merterenkandilli/EE463-Term-Project-Group-1/README.md

# EE463-Term-Project-Group-1
EMK
This is repo for EE463 term project of group1
