merterenkandilli/EE463-Term-Project-Group-1/Thermal Calculations.docx

Thermal Calculations

In this part of the report, the thermal analysis of the design is displayed. The main losses in the design are caused by the semiconductor devices. The most significant losses occur in a semiconductor while it is in conduction mode or it is switching. One can find the approximate total loss by adding the conduction loss and switching loss as shown in Equation 4.1.

P_(loss) = P_(conduction) + P_(switching)

Equation 4.1

The conduction losses can be calculated by two methods as shown in Equation 4.2 and Equation 4.3. In the first method, one can use the forward voltage drop of the semiconductor ( V_f ) to calculate the power dissipation. Another possible method is to use the on-resistance value ( R_(ds) ) indicated in the datasheet.

P_(conduction) = V_f ×I_(on) ×(Duty Cycle)

Equation 4.2

P_(conduction) = R_(ds) ×I_(on)^2 ×(Duty Cycle)

Equation 4.3

Switching losses can be calculated as shown in Equation 4.4 by using the turn on energy ( E_(on) ) and turn off energy ( E_(off) ) dissipated while the diode is switching . If these parameters are not indicated in the datasheet, the switching loss can be estimated by using the turn on delay time ( t_(rise) ) and turn of delay time ( t_(fall) ) as displayed in Equation 4.5.

P_(switching) =(E_(on) + E_(off) )×f

Equation 4.4

P_(switching) ≃ I_(on) × V_(on) ×(t_(rise) +t_(fall) )×f

Equation 4.5

For the rectifier block, two single phase bridge rectifiers (KBPC3510) are combined to construct a three phase full bridge rectifier. The switching energy or delay times are not indicated in the datasheet of the component. The maximum V_f is indicated as 1.1V in the datasheet. In maximum load case, the average current passing on one diode is 11 A when the diode is in conduction mode. One diode’s duty cycle is 1/6. There are 4 diodes that is working in one rectifier while only 2 diodes are working in the other.

P_(loss-rectifier1) =(1.1V)×(11A)×(1/6)×4=8.07W

P_(loss-rectifier2) =(1.1V)×(11A)×(1/6)×2=4.03W

The diode used in buck converter is DHG30I600PA.The diode’s conduction loss depends on both on-current and duty cycle. The maximum current is 11 A but the conduction loss is low because the duty cycle is 0.1 at that current. Thus, the maximum conduction loss occurs when duty cycle is 0.5 and the current is approximately 6A. Since the switching energy dissipation is not indicated in the datasheet, the Equation 4.5 is used to calculate switching loss. The switching loss is maximum when the duty cycle of the switch is maximum (0.9) since the current is maximum (0.44W). However, the conduction loss is more dominant than switching loss for this application in general. Thus, the worst case is calculated for 0.5 duty cycle.

P_(loss-diode,conduction) = 2.27V × 6A × 0.5 = 6.81W

P_(loss-diode,switching) ≃ 6A × 202V×(40 ns)×(5 kHz)=0.24W

P_(loss-diode) ≃7.05W

In IGBT, the maximum switching loss and conduction loss occur when duty cycle is 0.9. The calculations are displayed below.

P_(loss-IGBT,conduction) = (1.5V) × (11.2 A) × 0.8 =13.44W

P_(loss-IGBT,switching) =(0.3mJ+0.4mJ)× (5kHz)=3.5W

P_(loss-IGBT) =16.94W

To find the maximum thermal resistance of the heatsink, the following two equations are used.

R_(th-needed) = R_(jc) +R_(th-heatsink)

Equation 7

R_(th-needed) =(T_(max) -T_(ambient) )÷(P)

Equation 8

For rectifiers;

R_(th-needed,rectifier1) =(150-25)C^o ÷(8.07)=15.45 C/W

R_(th-heatsink,rectifier1) = 15.45 C/W -2 C/W = 13.45 C/W

R_(th-needed,rectifier2) =(150-25)C^o ÷(8.07)=31.02 C/W

R_(th-heatsink,rectifier2) = 15.45 C/W -2 C/W = 29.02 C/W

For diode (buck converter);

R_(th-needed,diode) =(125 C^o )÷(7.05)=17.73 C/W

R_(th-heatsink,diode) = 17.73 C/W -0.7 C/W = 17.03 C/W

For IGBT;

R_(th-needed,IGBT) =(125 C^o )÷(16.94)=7.38 C/W

R_(th-heatsink,IGBT) = 7.38 C/W -0.8 C/W = 6.58 C/W

In the implementation phase, we used a huge heatsink (thermal resistance is unknown but it is very low) and connected all of these semiconductor devices to this heatsink. Moreover, we used a fan to improve our thermal parameters.
