merterenkandilli/EE463-Term-Project-Group-1/controller/current_sense.PNG

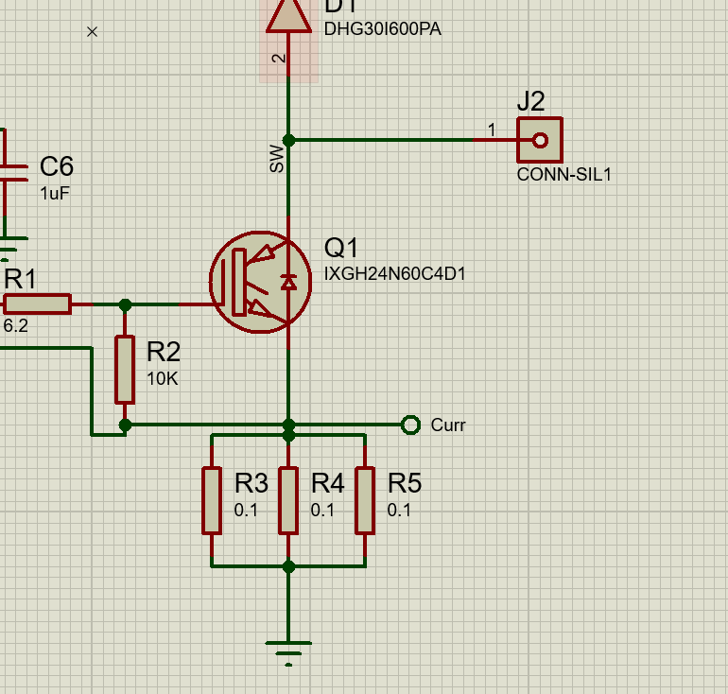
controller/current_sense.PNG
