merterenkandilli/EE463-Term-Project-Group-1/controller/kelvin.PNG

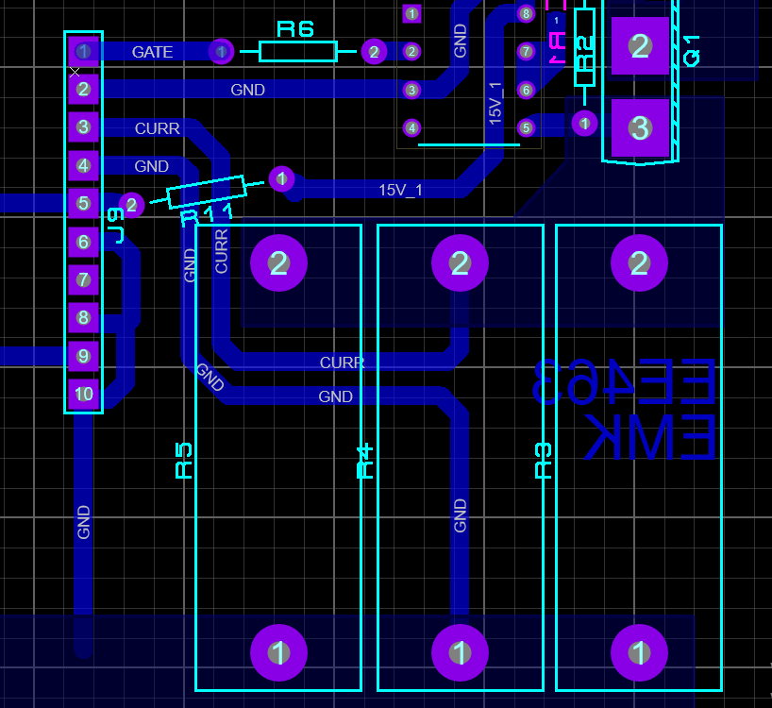
controller/kelvin.PNG
