merterenkandilli/EE463-Term-Project-Group-1/controller/pinout.PNG

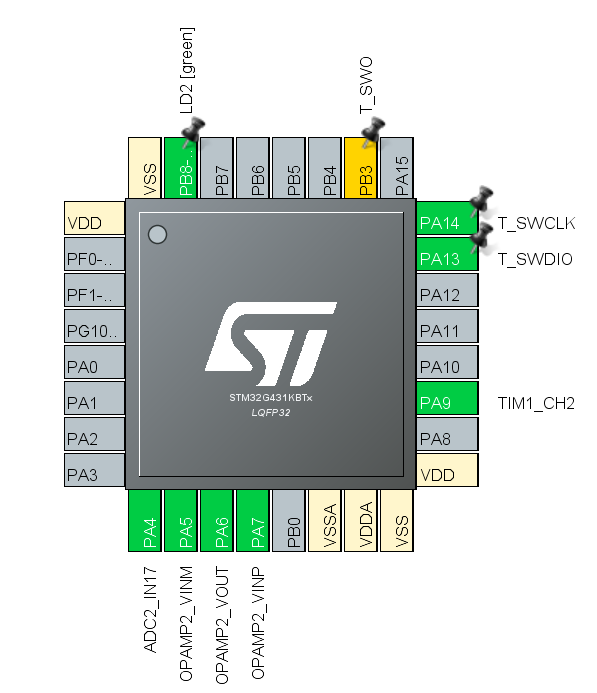
controller/pinout.PNG
