merterenkandilli/EE463-Term-Project-Group-1/controller/start.PNG

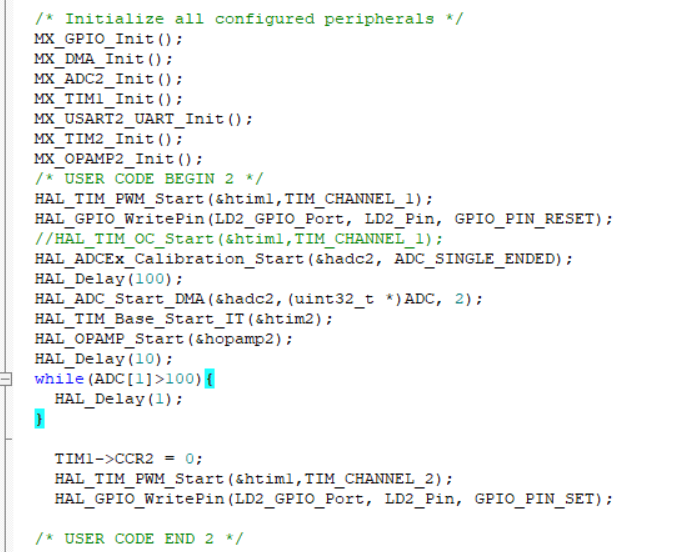
controller/start.PNG
