merterenkandilli/EE463-Term-Project-Group-1/figures/armature_current_ar_ss.png

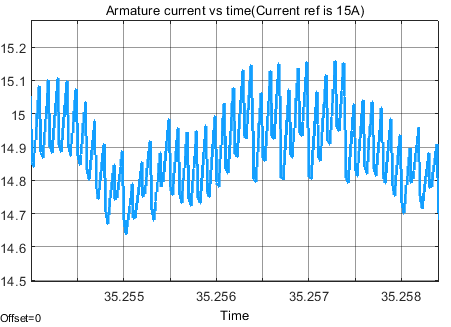
figures/armature_current_ar_ss.png
