merterenkandilli/EE463-Term-Project-Group-1/figures/armature_current_at_startup.png

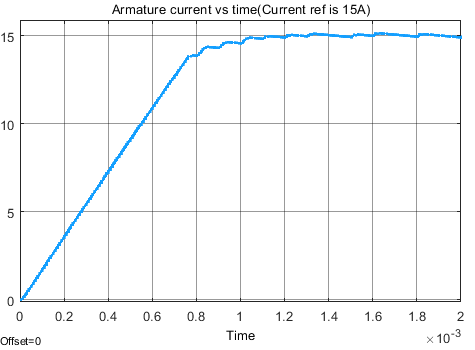
figures/armature_current_at_startup.png
