merterenkandilli/EE463-Term-Project-Group-1/figures/freewheeling_current_long.png

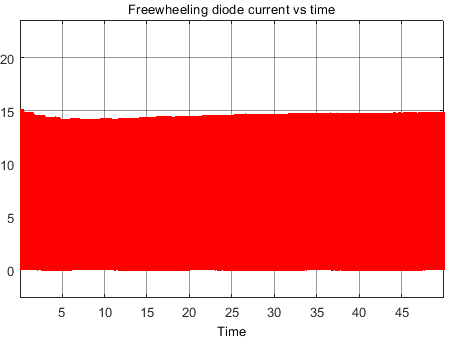
figures/freewheeling_current_long.png
