merterenkandilli/EE463-Term-Project-Group-1/figures/freewheeling_voltage_short2.png

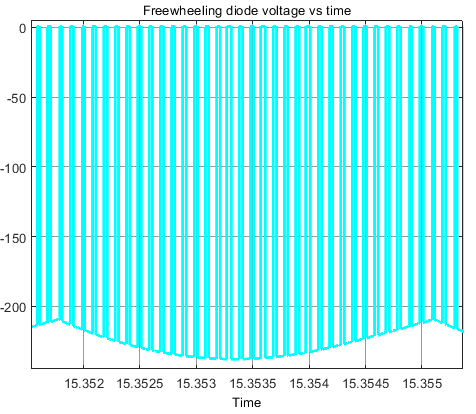
figures/freewheeling_voltage_short2.png
