merterenkandilli/EE463-Term-Project-Group-1/figures/igbt_current_long.png

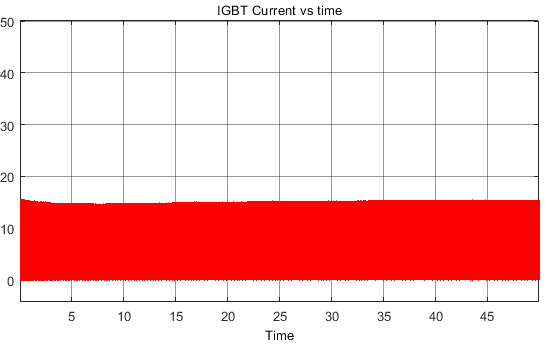
figures/igbt_current_long.png
