merterenkandilli/EE463-Term-Project-Group-1/figures/igbt_current_short2.png

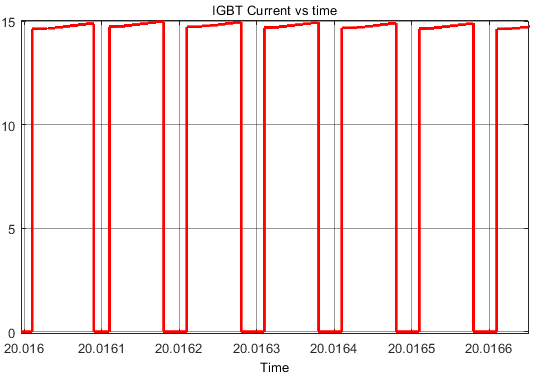
figures/igbt_current_short2.png
