merterenkandilli/EE463-Term-Project-Group-1/figures/igbt_currentvoltage_2.png

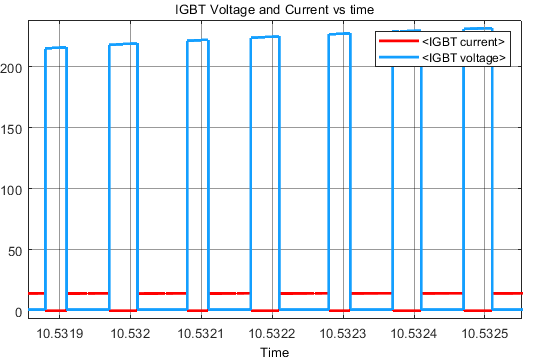
figures/igbt_currentvoltage_2.png
