merterenkandilli/EE463-Term-Project-Group-1/figures/igbt_voltage_short1.png

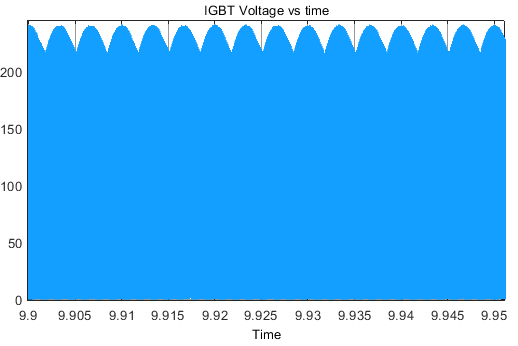
figures/igbt_voltage_short1.png
