merterenkandilli/EE463-Term-Project-Group-1/figures/igbt_voltage_short2.png

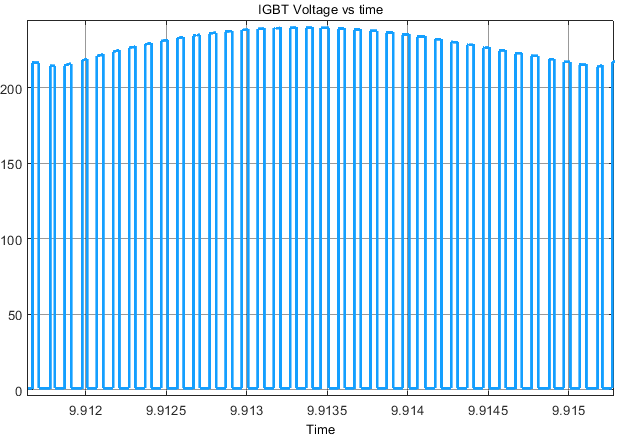
figures/igbt_voltage_short2.png
