merterenkandilli/EE463-Term-Project-Group-1/figures/model.PNG

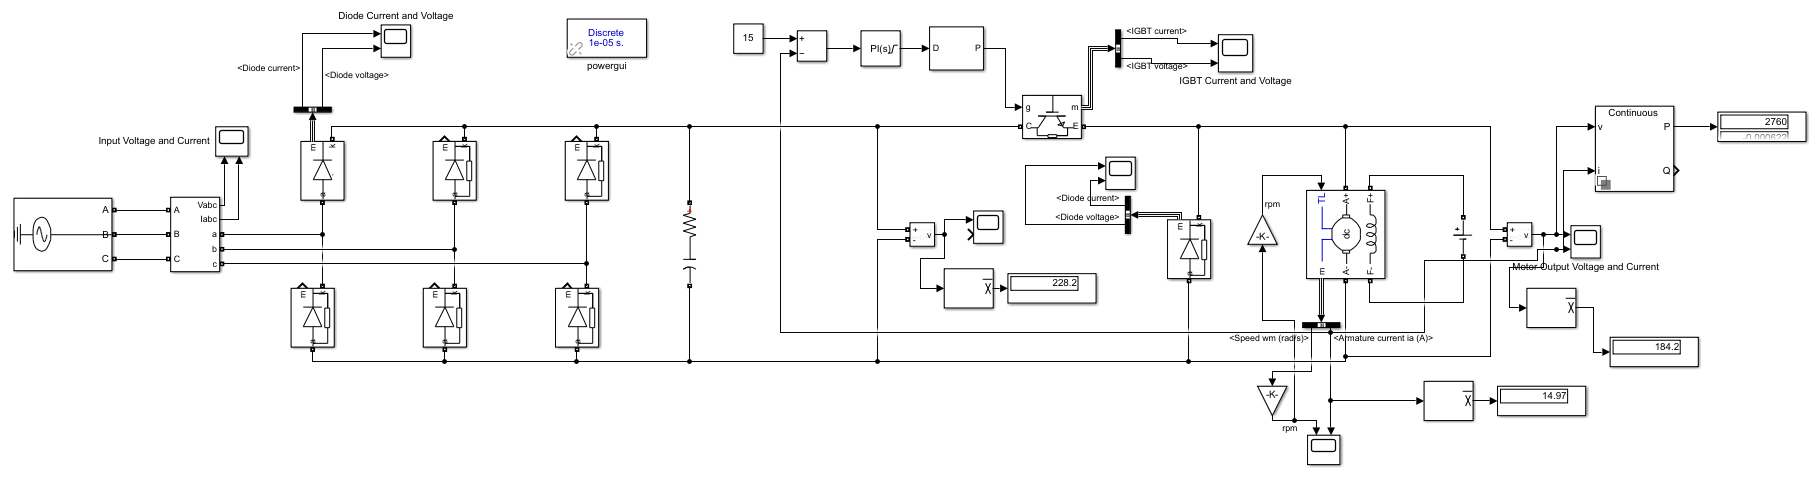
figures/model.PNG
