merterenkandilli/EE463-Term-Project-Group-1/figures/motor_rpm_current_long.png

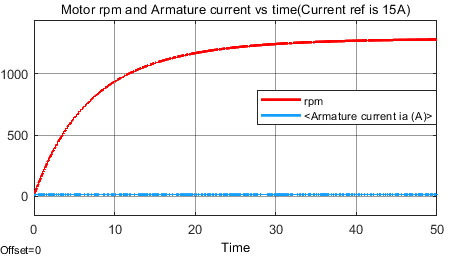
figures/motor_rpm_current_long.png
