merterenkandilli/EE463-Term-Project-Group-1/figures/rect_diode_current_longtime.png

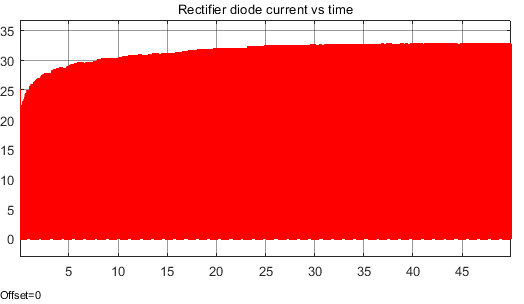
figures/rect_diode_current_longtime.png
