merterenkandilli/EE463-Term-Project-Group-1/figures/rect_diode_current_shorttime.png

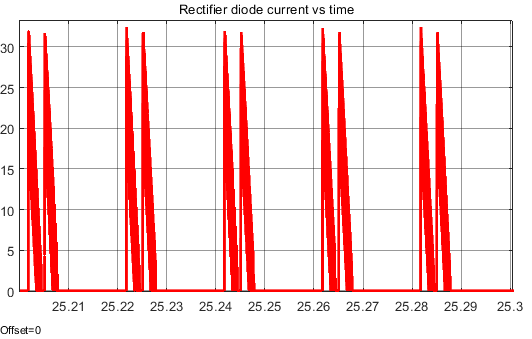
figures/rect_diode_current_shorttime.png
