merterenkandilli/EE463-Term-Project-Group-1/figures/rect_diode_voltage_shorttime.png

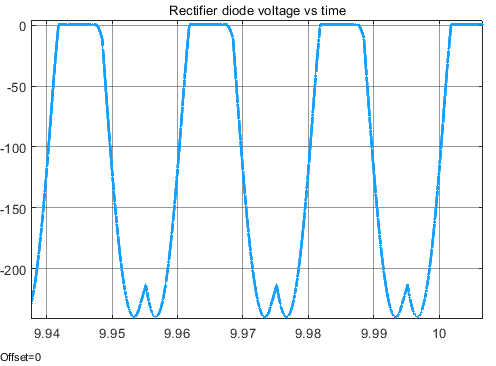
figures/rect_diode_voltage_shorttime.png
