merterenkandilli/EE463-Term-Project-Group-1/figures/rectifier_output_voltage_short1.png

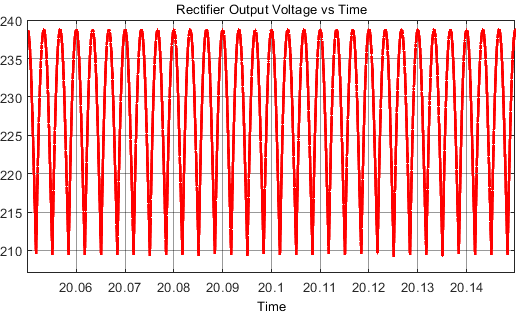
figures/rectifier_output_voltage_short1.png
