merterenkandilli/EE463-Term-Project-Group-1/gatedrive/ideal_plot.png

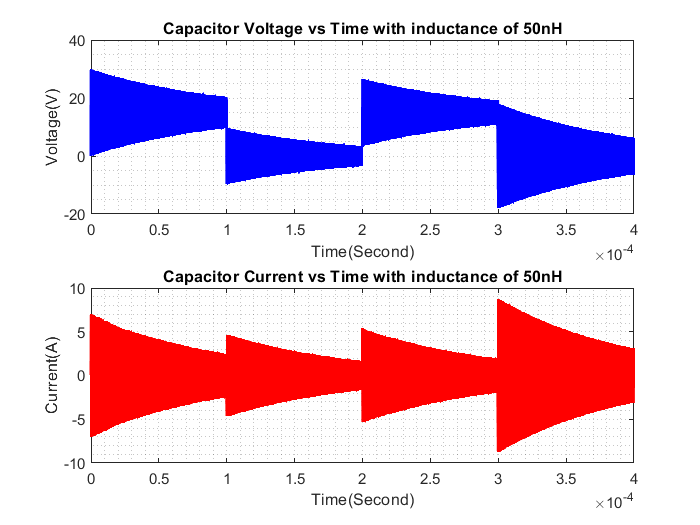
gatedrive/ideal_plot.png
