merterenkandilli/EE463-Term-Project-Group-1/gatedrive/ideal_spice.PNG

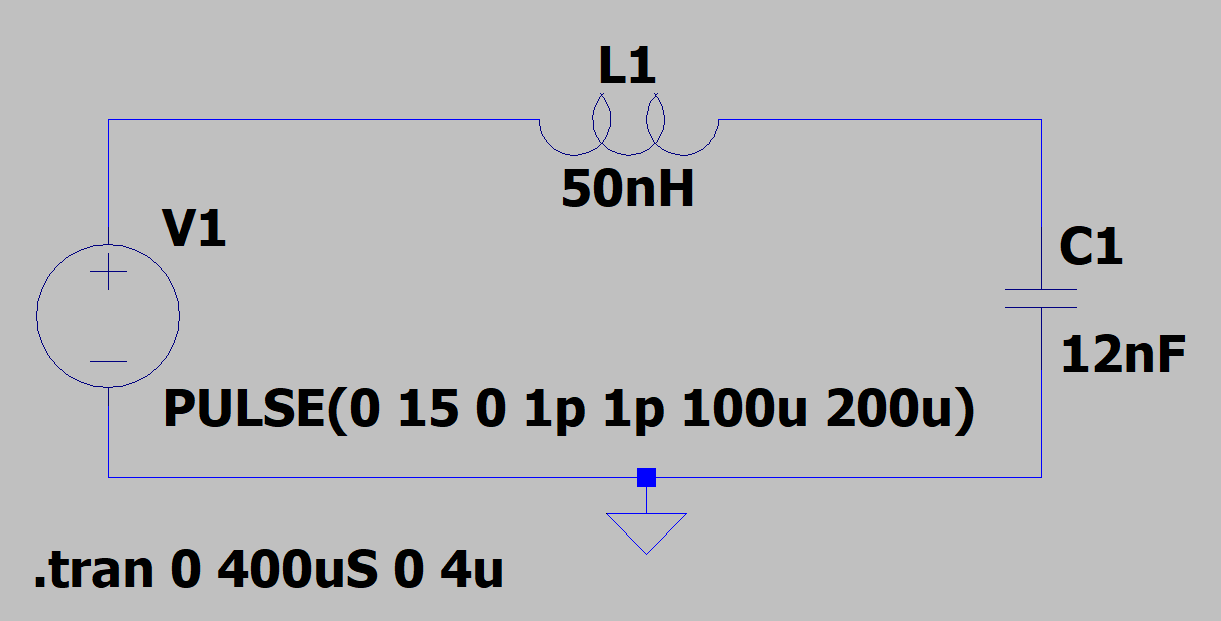
gatedrive/ideal_spice.PNG
