merterenkandilli/EE463-Term-Project-Group-1/gatedrive/layout.png

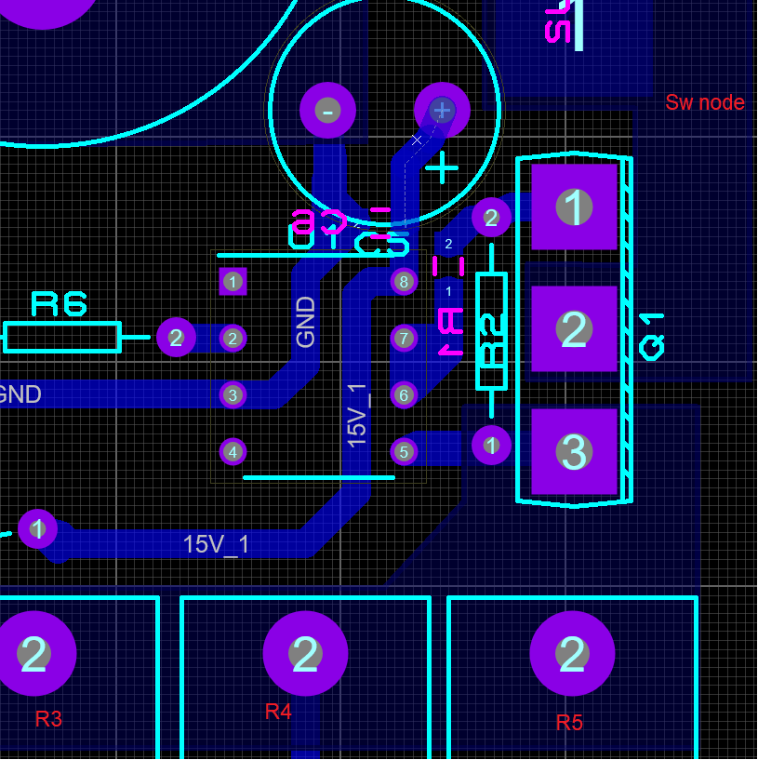
gatedrive/layout.png
