merterenkandilli/EE463-Term-Project-Group-1/gatedrive/LR_plot.png

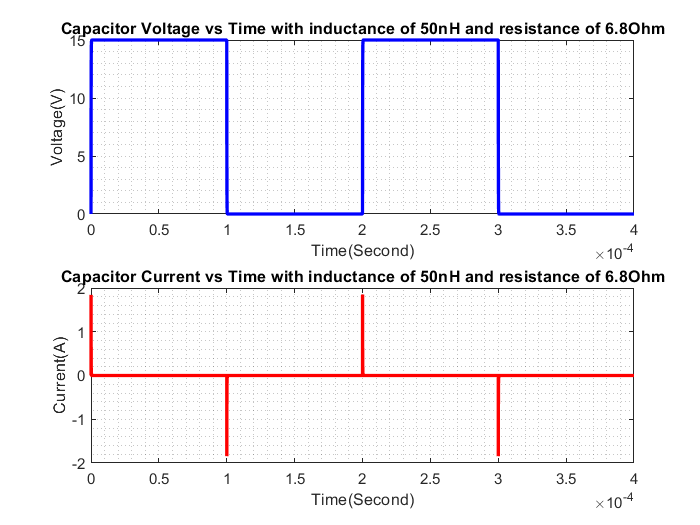
gatedrive/LR_plot.png
