merterenkandilli/EE463-Term-Project-Group-1/gatedrive/sch.PNG

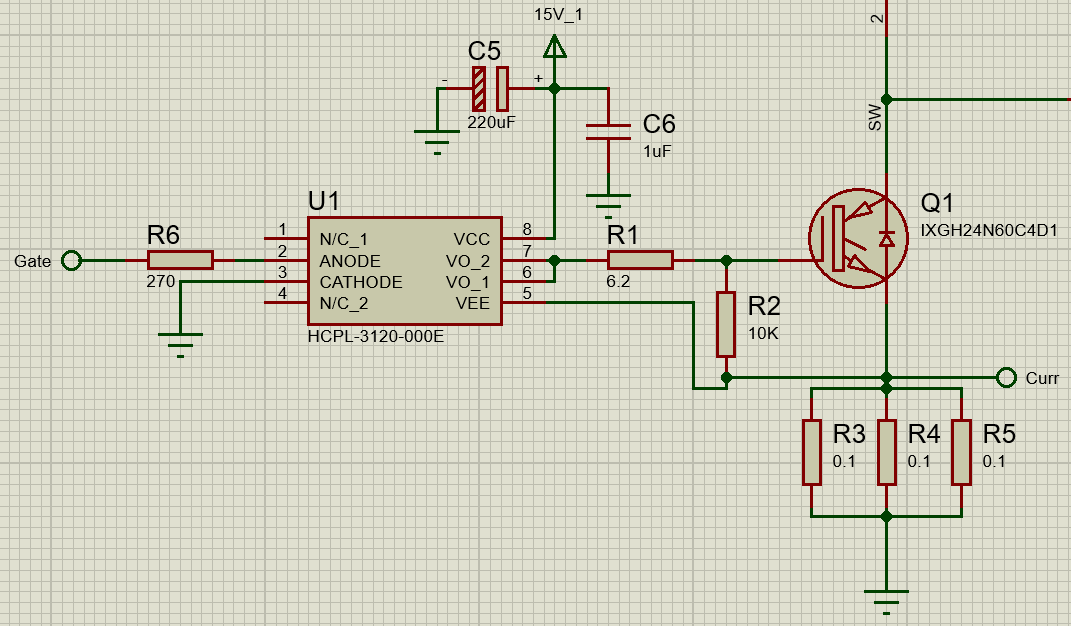
gatedrive/sch.PNG
