merterenkandilli/EE463-Term-Project-Group-1/gatedrive/tlp250.PNG

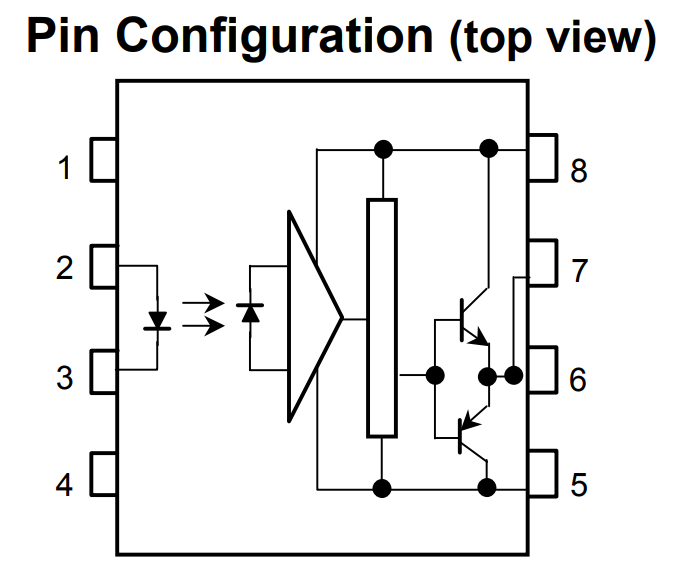
gatedrive/tlp250.PNG
