merterenkandilli/EE463-Term-Project-Group-1/gatedrive/very_ideal_plot.png

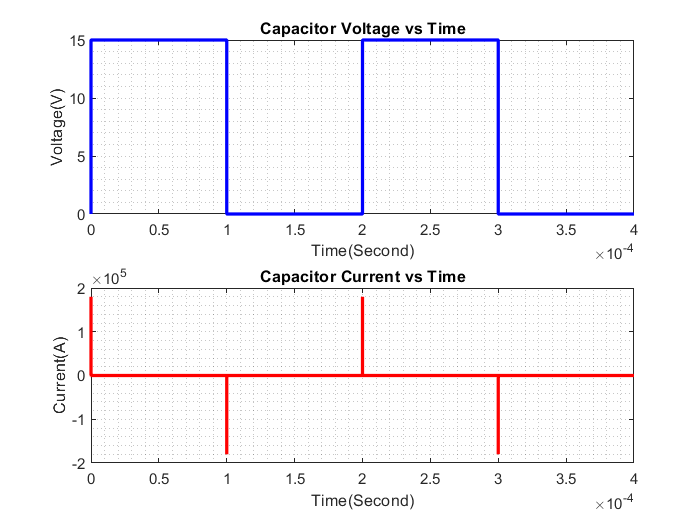
gatedrive/very_ideal_plot.png
