merterenkandilli/EE463-Term-Project-Group-1/gatedrive/very_ideal_spice.PNG

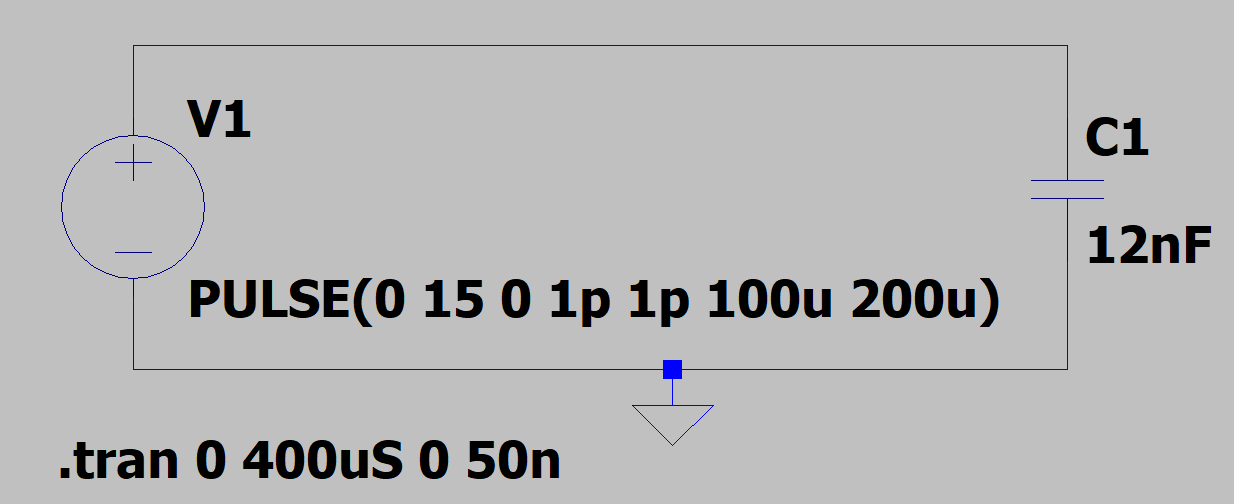
gatedrive/very_ideal_spice.PNG
