merterenkandilli/EE463-Term-Project-Group-1/TL494/TL494_Schematic.jpg

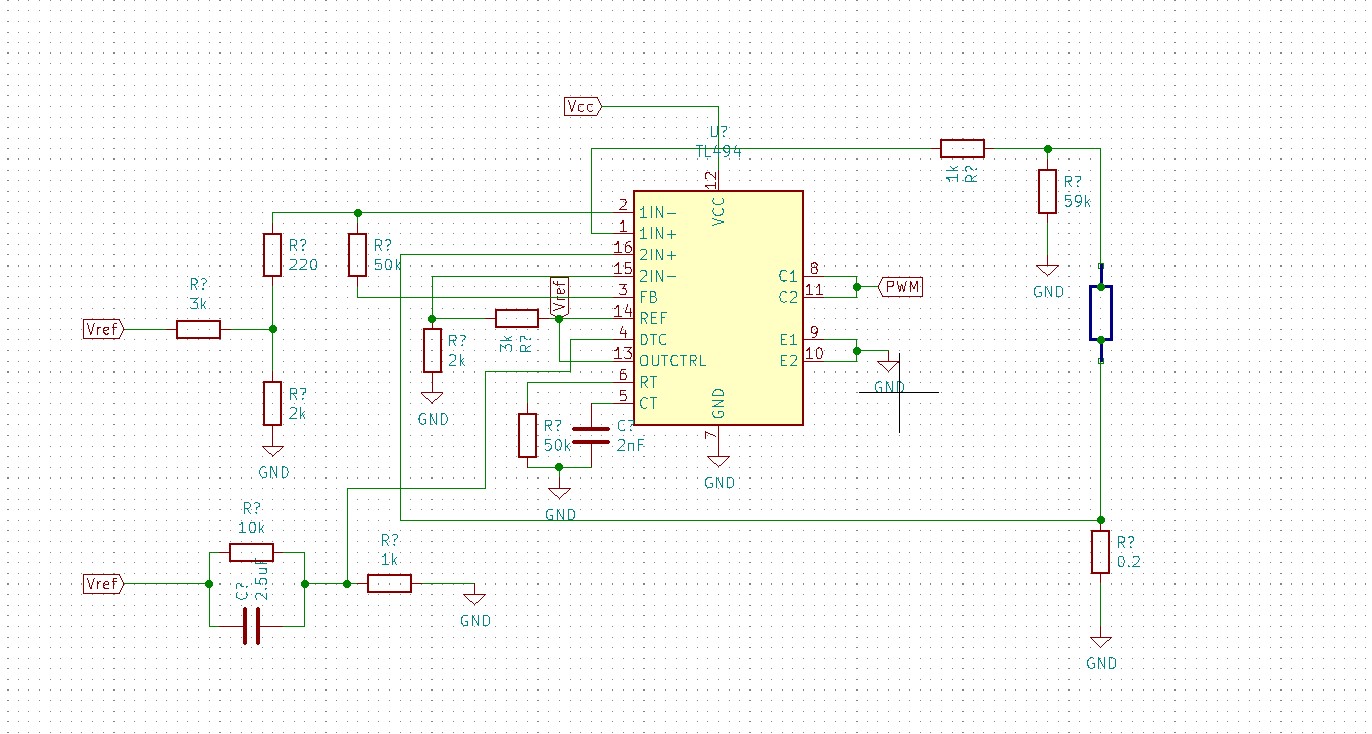
TL494/TL494_Schematic.jpg
