merterenkandilli/EE463-Term-Project-Group-1/Component List/Component List.xlsx

Component |  | Quantitiy |  | Link |  | Current Rating | Voltage Rating
Filter Capacitor | PKL5-400V221MN400 | x2 | 48,35TL | https://ozdisan.com/pasif-komponentler/kondansatorler/aluminyum-kondansatorler/PKL5-400V221MN400 | IGBT | 30A | 600V
Rectifier | 35A 1000V Bridge Rectifier | x2 | 11,73TL | https://www.direnc.net/35a-1000v-kopru-diyot | Diode | 30A | 600V
IGBT | IXGH24N60C4D1 N Channel | x1 | 36,45TL | https://www.direnc.net/ixgh24n60c4d1-rohs-24a600v-to247ad-igbtdiode | Rectifier | 35A | 1000V
Controller | TL494 | x1 | 4,69TL | https://www.direnc.net/tl494--025a-switching-controller-300khz-switching-freq-max | Capacitor |  | 400V
Diode | DHG30I600PA | x1 | 25TL | https://ozdisan.com/guc-yari-iletkenleri/diyotlar-modul-diyotlar-ve-dogrultucular/genel-amacli-diyotlar/DHG30I600PA
Film Capacitor | C322J104J60A605 | x1 | 2,4TL | https://ozdisan.com/pasif-komponentler/kondansatorler/film-kondansatorler/C322J104J60A605
Cement Resistor | PRW05WJW10KB00 | x3 | 14,65TL | https://ozdisan.com/pasif-komponentler/direncler/tas-direncler/PRW05WJW10KB00
Heat Sink | 530802B05100G | x1 | 31,6TL | https://ozdisan.com/elektromekanik-komponentler/sogutucular/aluminyum-sogutucular/530802B05100G
