merterenkandilli/EE463-Term-Project-Group-1/EE463.PDF

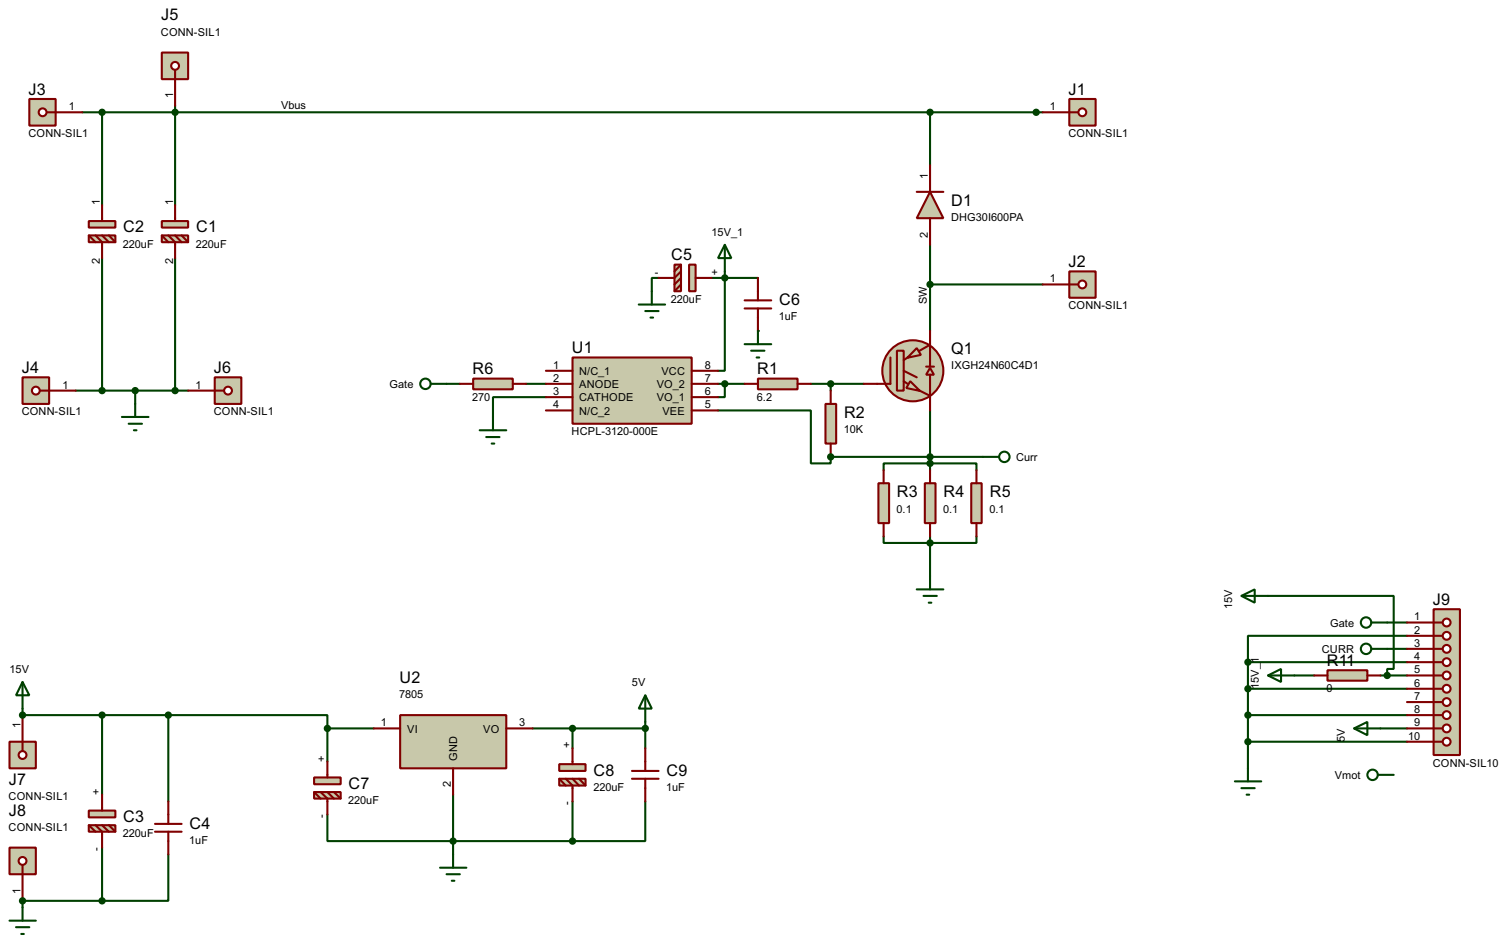
[picture p52: page 1]

SW Vbus Q1 IXGH24N60C4D1 1 2 D1 DHG30I600PA N/C_1 1 ANODE 2 CATHODE 3 N/C_2 4 VCC 8 VO_2 7 VO_1 6 VEE 5 U1 HCPL-3120-000E R1 6.2 1 J1CONN-SIL1 1 J2CONN-SIL1 R2 10K R3 0.1 R4 0.1 R5 0.1 1 2 C1 220uF 1 2 C2 220uF 1 J3CONN-SIL1 1 J4CONN-SIL1 1 J5CONN-SIL1 1 J6CONN-SIL1 1 J7CONN-SIL1 1 J8CONN-SIL1 15V + - C3 220uF C4 1uF 15V_1 - + C5 220uF C6 1uF R6 270 GateVI 1 VO 3 GND 2 U2 7805 + - C7 220uF + - C8 220uF C9 1uF 5V Curr 12345678910 J9CONN-SIL10 Gate CURR Vmot 15V_1 5V R11 0 15V
