merterenkandilli/EE463-Term-Project-Group-1/control_board.PDF

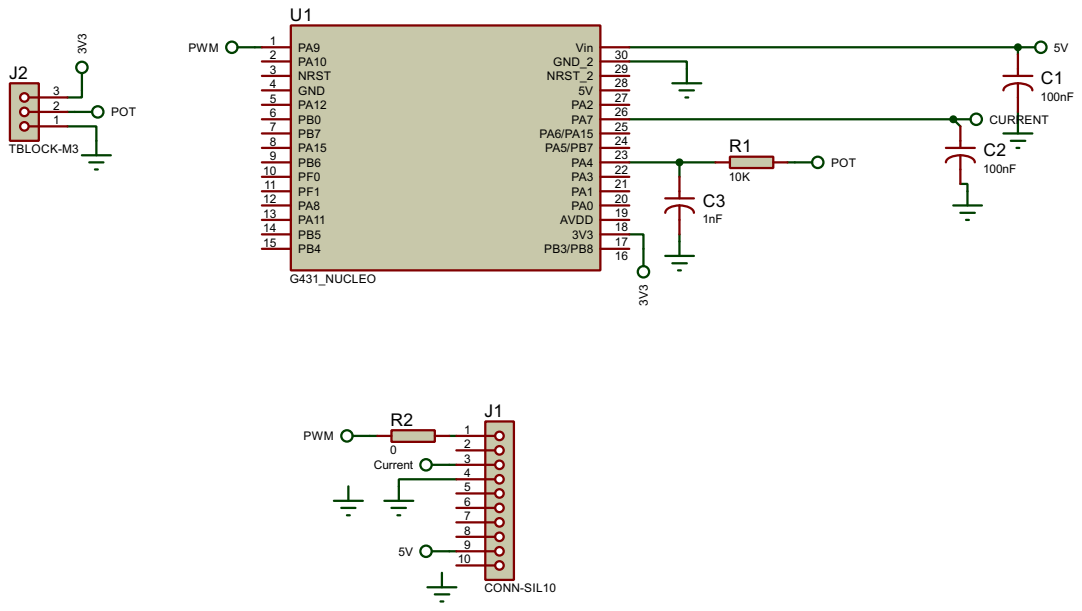
[picture p53: page 1]
