merterenkandilli/EE463-Term-Project-Group-1/gatedrive/gatedrive_ideal.asc

C1: cap; 12nF
L1: ind; 50nH
V1: voltage; PULSE(0 15 0 1p 1p 100u 200u)
Named nets: 0
.tran 0 400uS 0 4u
