merterenkandilli/EE463-Term-Project-Group-1/gatedrive/gatedrive_lessideal.asc

C1: cap; 12nF
L1: ind; 50nH
R1: res; 6.8
V1: voltage; PULSE(0 15 0 1p 1p 100u 200u)
Named nets: 0
.tran 0 400uS 0 10n
