merterenkandilli/EE463-Term-Project-Group-1/gatedrive/gatedrive_veryideal.asc

C1: cap; 12nF
V1: voltage; PULSE(0 15 0 1p 1p 100u 200u)
Named nets: 0
.tran 0 400u 0 1000
