merterenkandilli/EE463-Term-Project-Group-1/(list of files, drawings)

Other design files:
control_board.pdsprj
EE463.pdsprj
