merterenkandilli/EE463-Term-Project-Group-1/(commit log)

2022-01-02 TL494 Schematic is uploaded
2022-01-02 component list v1
    [Component List.xlsx]
2022-01-02 comp list
    [Component List.xlsx]
2022-01-02 Component List updated v2
    [Component List.xlsx]
2022-01-02 Heat Sink is added to the Component List v3
    [Component List.xlsx]
2022-01-02 Thermal calculations and buck converter explanation
    Thermal calculations and buck converter explanation
